Marcos-utn/proyecto_informatica_2/LEEME_Montaje_y_Calibracion.docx

# Monitor de vibraciones

Montaje, puesta en marcha y ajuste

# 1. Instalación del software

1. Arduino IDE: instalar el soporte “Arduino UNO R4 Boards” desde el Gestor de placas. No requiere librerías externas (usa Wire y EEPROM, incluidas). Abrir Monitor_Vibraciones_Arduino.ino, elegir Arduino UNO R4 WiFi y subir.
2. Cerrar el Monitor Serie del IDE, porque ocupa el puerto.
3. Processing 4: abrir Monitor_Vibraciones_Processing.pde (la carpeta debe llamarse igual que el archivo). No requiere librerías. Ejecutar, elegir el puerto con los botones < y > (el botón R refresca) y pulsar CONECTAR.

El Arduino funciona también solo: LEDs, zumbador y relé actúan sin el PC, y los umbrales se guardan en EEPROM.

# 2. Materiales y conexiones

El esquema completo, la tabla de pines y la lista de materiales están en Diagrama_Conexiones.docx. Puntos que conviene tener presentes:

- Zumbador: debe ser activo. Si tiene el buzzer suelto, conéctelo con un transistor NPN (BC547, BC337 o 2N2222): zumbador + a 5V, zumbador − al colector, emisor a GND, base a D5 mediante 2,2 kΩ y un diodo 1N4148 en paralelo con el zumbador (raya hacia 5V). Si tiene un módulo de 3 pines, conecte VCC a 5V, GND a GND e IO a D5. El programa es el mismo en ambos casos.
- Por qué el transistor: un buzzer suelto consume unos 25 mA, más de lo recomendable para un pin del UNO R4 (alrededor de 8 mA; verifique la hoja de datos).
- Módulo de relé: el suyo se activa con 0 V (nivel bajo) y tiene entradas optoacopladas; el programa ya está configurado así. Los cuatro canales (IN1 a IN4) van a D7 a D10 y conmutan a la vez L1, L2, L3 y N.
- Alimentación de las bobinas: con cuatro relés, retire el puente JD-VCC–VCC y alimente las bobinas con una fuente de 5 V independiente (consulte la serigrafía de su placa). Así no carga el Arduino y se mantiene la aislación.
- Motor: ver la sección 8 (potencia, límites de los relés y medidas de seguridad).
- Pulsador ACK: normalmente abierto y momentáneo, entre D6 y GND, sin resistencia externa.
- Sensor: cables cortos (menos de 30 cm) y pines soldados; alimentación a 3.3V.

# 3. Fijación del sensor

Es lo más importante para obtener medidas útiles.

- Fijar con tornillo, espárrago o adhesivo rígido (epoxi o cianoacrilato) sobre la carcasa, lo más cerca posible del rodamiento. Los imanes y la cinta de doble cara filtran las altas frecuencias.
- Alinear un eje del sensor con la dirección radial (horizontal o vertical) y mantener siempre la misma posición para poder comparar en el tiempo.
- Usar una superficie limpia y plana, sin pintura gruesa.

# 4. Calibración

1. Con el motor parado y el sensor montado, pulsar CALIB. RUIDO. Mide el ruido propio del sensor (típico 0,1–0,3 mm/s) y lo descuenta. Se guarda en EEPROM.
2. Arrancar el motor en buen estado y anotar la velocidad RMS de referencia tras unos minutos de funcionamiento (línea base).
3. Introducir las rpm del motor en Processing: aparecen las marcas 1×, 2× y 3× en el espectro.
4. Ajustar los umbrales con + y −; se envían al Arduino y se guardan al instante.

# 5. Umbrales orientativos

Velocidad RMS, banda 10–1000 Hz según la norma. Verificar siempre con la norma vigente (ISO 20816 / ISO 10816) y con el fabricante.

Tipo de máquina | Normal → Alerta | Alerta → Alarma
Hasta 15 kW (clase I) | 1,8 mm/s | 4,5 mm/s (valores por defecto)
15–300 kW, cimentación rígida | 2,8 mm/s | 4,5 mm/s

Consejo práctico: además de la norma, fije la alerta en 1,5–2 veces la línea base de su propio motor. En mantenimiento predictivo la tendencia importa más que el valor absoluto.

# 6. Interpretación rápida del espectro

Pico dominante | Causa probable
1× rpm (radial) | Desequilibrio
2× rpm (a veces axial) | Desalineación
Múltiples armónicos de 1× | Holgura mecánica
2× frecuencia de red (100 / 120 Hz) | Problema eléctrico (excentricidad, barras rotas)
Factor de cresta > 6 con velocidad baja | Impactos: posible rodamiento incipiente

# 7. Lógica de alarma

- Para subir de nivel se necesitan N lecturas consecutivas (por defecto 3, unos 3 s) por encima del umbral.
- Para bajar hacen falta N lecturas por debajo del umbral menos un 10 % (histéresis).
- ACK (botón físico o Processing) silencia el zumbador mientras dure esa alarma; el LED rojo sigue encendido.
- Disparo del motor: si se activa DISPARO AUTO, una alarma confirmada desconecta el motor y queda enclavada (ver sección 8).

# 8. Maniobra del motor (conectar y desconectar)

El motor se conecta y desconecta desde Processing (botón ARRANCAR / PARAR MOTOR). Los cuatro relés del módulo conmutan a la vez L1 (CH1), L2 (CH2), L3 (CH3) y N (CH4), con sus bornes COM y NO. Esquema en Diagrama_Potencia_Directo.svg (Opción A).

Cálculo de referencia (confirme con la chapa del motor):

- 0,75 HP son unos 0,56 kW. Un motor trifásico de 380 V consume alrededor de 1,3–1,5 A nominales y arranca con 8–11 A durante menos de un segundo. Esto queda en el límite de los 10 A de los contactos, así que el margen es escaso.
- Conecte el motor para 380 V (estrella). Si fuera monofásico de 220 V, la corriente sería unas 3 veces mayor (unos 5 A nominales y más de 25 A de arranque) y estos relés no sirven.

Lo que los datos del módulo no cubren (el fabricante da 10 A / 250 V CA con carga resistiva):

- Tensión: entre fases hay 380 V y en un contacto abierto pueden aparecer 220 V o más. Se usa por encima de la tensión de catálogo.
- Aislación: la separación entre bornes vecinos está pensada para 220 V como máximo. Monte el módulo en una caja aislante, sin partes accesibles.
- Desgaste: con carga inductiva el arco acorta la vida de los contactos y uno puede quedar soldado. Entonces el motor trabaja con dos fases, algo que el relé térmico con protección por falta de fase debe detectar. Revise los contactos periódicamente.

Medidas recomendadas:

- Termomagnética 4P y relé térmico o guardamotor regulado a la corriente de placa, aguas arriba del módulo y sin depender del Arduino.
- Fuente de 5 V externa para las bobinas (puente JD-VCC–VCC retirado) y parada de emergencia NC en serie con su +: corta los cuatro relés sin depender del Arduino.
- Opcional: red RC (100 Ω + 100 nF clase X2) en bornes de cada contacto. Deja una pequeña corriente de fuga (del orden de 10 mA), por lo que siempre hay que cortar el seccionador general antes de tocar el motor.
- Los cuatro relés no actúan en el mismo instante exacto: hay milisegundos de diferencia mecánica. Para un motor es aceptable.

Si necesita más margen o un motor mayor, la alternativa es comandar con el canal 1 la bobina de un contactor de 4 polos (N_RELES = 1 en el programa; ver Diagrama_Potencia_Contactor.svg, Opción B).

Cómo se comporta el sistema (seguridad):

- Al encender o reiniciar el Arduino el motor queda desconectado. Tras un corte de luz no arranca solo.
- Arranque con confirmación: el primer clic arma el botón y hay 3 s para confirmar con un segundo clic. Parar es inmediato.
- Disparo automático (botón DISPARO AUTO): si se confirma una ALARMA de vibración, el motor se desconecta. Queda enclavado: aunque la vibración baje, no rearranca solo; hay que pulsar RESET ESTADO y dar una nueva orden de arranque.
- Durante los primeros 15 s tras el arranque no se dispara (transitorio de arranque). Se ajusta con GRACIA_ARRANQUE_MS en el programa.
- Con DISPARO AUTO activo, el arranque exige que la medición esté en marcha y el sensor sin fallo. Si el sensor falla con el motor en marcha, el motor no se detiene por eso: se avisa con el parpadeo de los LEDs y un mensaje.
- Este sistema es un complemento de monitorización y maniobra; no sustituye las protecciones eléctricas.

# 9. Registro CSV

Se crea automáticamente al conectar, en registros/vibraciones_AAAAMMDD_HHMMSS.csv dentro de la carpeta del sketch. Usa punto y coma como separador y coma decimal, listo para Excel en español. Se guarda una fila por lectura (aproximadamente cada segundo).

# 10. Limitaciones a tener en cuenta

- Ancho de banda del MPU-6050: el filtro interno del acelerómetro llega a 260 Hz (−3 dB), por eso la velocidad se calcula en 10–250 Hz. Es válido para desequilibrio, desalineación, holguras y problemas eléctricos en motores de 1500/3000 rpm, pero no detecta bien fallos incipientes de rodamientos, que aparecen en frecuencias mucho más altas. Para eso hace falta un acelerómetro de mayor ancho de banda.
- El muestreo se temporiza por software. Si Processing muestra “Muestras perdidas” mayor que 0, el bus I2C no da abasto: bajar FS_HZ y ajustar F_HI_HZ.
- Es una herramienta de tendencia y preaviso, no un analizador certificado. Para decisiones críticas, contrastar con un instrumento calibrado.
- El código no se ha probado sobre hardware real. En la primera puesta en marcha compruebe con el motor parado (valores cercanos al ruido) y con una vibración conocida.
- Si el IDE avisa de poca RAM, ponga N = 512; K_LO y K_HI se recalculan solos.

# 11. Protocolo serie

Por si desea usar otro software en lugar de Processing (115200 baudios, líneas ASCII).

Sentido | Mensajes
Arduino → PC | D,ms,estado,vmax,vx,vy,vz,aRMS_g,aPico_g,cresta,fdom,acked,errores · S,binHz,n,v0..vn · C,... (incluye motor y disparado) · I,... · E,...
PC → Arduino | START · STOP · GET · ACK · RESET · ZERO · ZEROCLR · TH,alerta,alarma,lecturas · RELAY,0|1 (disparo automático) · MOTOR,0|1

Monitor de vibraciones – Arduino UNO R4 WiFi + MPU-6050 | Página
