Marcos-utn/proyecto_informatica_2/(commit log)

2026-10-23 Motor:Boton de arranque,Confirmacion y Estado del motor en pantalla
2026-10-23 Motor:Control,solicitud de conexion y desconexion por sotfware,estado de desconexion,Bloqueo hasta reiniciar
2026-10-23 Reles:1->4,cambio en la actualizacion de salida,cambio en la deteccion de fallos
